GitBMP/npx25/_3d-print/npx25.FCStd

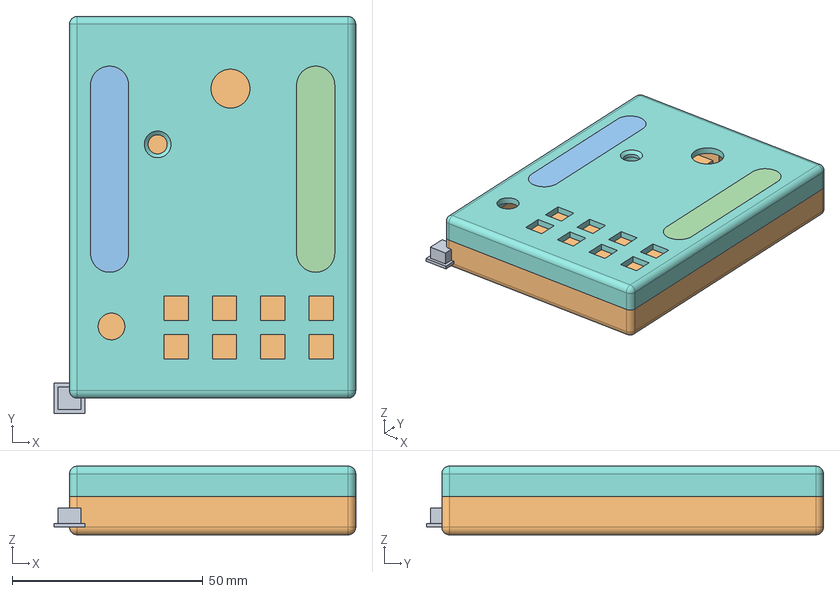
[picture p9: CAD file, 2026-10-16]
_3d-print/npx25.FCStd
79.0 x 104.0 x 18.0 mm
Button
Bottom
LED-Counterpart-1
LED-Counterpart-2
git-link-2-1
git-link-2-2
git-link-2-3
