GitBMP/npx25/(commit log)

2026-10-12 Initial commit: NPX25 ESP32-C3 NeoPixel LED controller
    MicroPython firmware with JSON config system, component metadata,
    sensor pipelines, state machine and Microdot-based web dashboard.
2026-10-16 WIP: README.md
    Hardware sections, dashboard, config-to-card walk-through, 3d-print README, images.
    [npx25.FCStd]
2026-10-16 README: software sections, status, credits; move docs and 3d-print out of upload path
    [npx25.FCStd]
